jas26xinyi/2026FPGA/password_lock_system/实机验证报告.md

# FPGA 密码锁实机验证报告

## 验证环境

- 开发板：HX7A75A，器件 `xc7a75tfgg484-2`
- 工具：Vivado 2023.2
- 当前构建参数：`ENABLE_RPI_CAMERA=1`
- 输入设备：连接至 J2 的 4×4 矩阵键盘
- 下载方式：JTAG 下载 `password_lock_top.bit`

## 已通过项目

| 项目 | 实测结果 |
|---|---|
| 上电初始化 | 正常进入 `PASS` 等待状态 |
| 数码管 | 位选、段码和状态文字显示正确 |
| 矩阵键盘 | 调整 FPGA 行列管脚角色后，16 键映射正确 |
| SW1 输入启动 | 低到高拨动后进入密码输入状态 |
| 默认密码 | `1234` 可正常进入 `OPEN` |
| 输入编辑 | 数字输入、`B` 退格、`C` 取消和不足四位确认均正确 |
| 8 秒超时 | 未开锁且无操作时回到 `PASS` |
| 16 秒超时 | `OPEN` 后无操作自动上锁并回到 `PASS` |
| 错误计数 | 依次显示 `Err1`、`Err2`、`Err3`，第四次进入 `ALAr` |
| 报警解除 | 报警时矩阵键盘无权解除，仅 KEY2 有效 |
| 解除后计数 | KEY2 后重新输入，下一次错误从 `Err1` 开始 |
| 解除后输入 | KEY2 后直接恢复新一轮输入，无需重新拨动 SW1 |
| 报警显示 | LED4 按约 2 Hz 节拍闪烁 |
| 蜂鸣器 | 当前实板 P20 为高电平使能，间歇报警音正常 |
| 管理员改密 | KEY1、`SEt`、四位密码、`A`、`SAVE` 流程正常 |
| 新旧密码切换 | 新密码 `2580` 生效，旧密码 `1234` 被拒绝 |
| Flash 复位恢复 | KEY4 复位后仍可使用 `2580` |
| Flash 掉电保持 | 断电 5 秒、重新上电并下载同一程序后，`2580` 仍可开锁 |
| FPGA→Pi 报警串口 | 第四次错误后 Raspberry Pi 收到 `ALARM` 并成功回传 ACK |
| CSI 四帧抓拍 | 两轮真实报警均完成四张 `640×480` JPEG，单轮约 1.35 秒 |
| HDMI 四宫格 | 抓拍后全屏显示最新 `mosaic.jpg`，第二轮报警会替换为新画面 |
| 报警解除后图像保留 | KEY2 停止声光报警后，HDMI 四宫格持续显示，不退回色条 |

## 实测中修正的问题

- 数码管位选改为共阳低有效，并按板卡实际位序修正约束。
- 矩阵键盘接线呈转置关系，通过交换 FPGA 行/列端口角色修正，不要求重新接线。
- 管理员解除报警时清零错误次数，避免出现 `Err5` 至 `Err7`。
- KEY2 解除报警后直接进入新输入会话，同时复位键盘扫描器。
- 蜂鸣器极性以当前实板为准改为高电平使能；旧版手册的低电平说明不适用于当前板卡。
- 当前实板操作方向确认：SW1 拨上后可进入工作状态并使用 KEY1 进入 `SEt`；SW5 拨上后蜂鸣器通路接通。
- W25Q64 的连续 SPI 指令之间加入安全的片选高电平间隔；修正后写入、回读、复位恢复和掉电保持均通过。

## 尚未进行的硬件验证

新增的 KEY3 临时密码功能已完成 RTL 仿真，包括四位十进制密码生成、固定密码与临时密码并行开锁、再次生成后旧临时密码失效，以及复位后临时密码清除。该功能尚未将新版位流下载到开发板复测，因此暂不列入上方实机通过项目。

原有 FPGA 直连 OV5640、四帧 BRAM 和 HDMI 输出方案已经删除。新方案使用 FPGA UART 通知 Raspberry Pi 5，由树莓派连接 CSI 摄像头并输出 HDMI 四宫格；该新链路已完成板间接线、CSI 相机与显示器联调。

## 新方案本地验证

- FPGA UART 字节发送、接收、`ALARM` 消息、`ACK` 识别和未确认重发测试通过。
- 基础功能、临时密码与拍摄接口共 11 组 Vivado XSim 仿真全部通过；原生 WDB/VCD、PNG 和日志位于仓库根目录 `simulation_waveforms/`。
- `ENABLE_RPI_CAMERA=1` 的综合和实现均为 0 error，DRC 违规为 0；WNS `11.318 ns`、WHS `0.060 ns`，全部时序约束满足。
- `ENABLE_RPI_CAMERA=0` 的 RTL 综合检查通过，确认参数关闭路径有效。
- 树莓派协议、四宫格顺序和启动恢复共 6 项 Python 单元测试通过。
- 2026-09-08 实机联调确认 GPIOA UART、Raspberry Pi 5、CSI OV5647 相机与 HDMI 显示器完整工作；两次报警生成不同哈希的 `mosaic.jpg`，旧记录同时保留。
- 树莓派桌面登录自启动已安装；程序重启后可恢复最新四宫格并继续监听 `/dev/ttyAMA0`。

## 当前板上密码

实机验证结束时，W25Q64 中保存的管理员密码为 `2580`。如需恢复为 `1234`，按 KEY1 进入 `SEt`，输入 `1234` 后按 `A`，等待 `SAVE` 返回 `PASS`。
