jas26xinyi/2026FPGA/simulation_waveforms/12_lock_controller_fsm/notes/14_open_timeout.md

# 14_open_timeout：开锁 2000 拍自动关锁

窗口：**34470–54660 ns**，连续绝对时间；scenario=14。

## 原生 Vivado 截屏

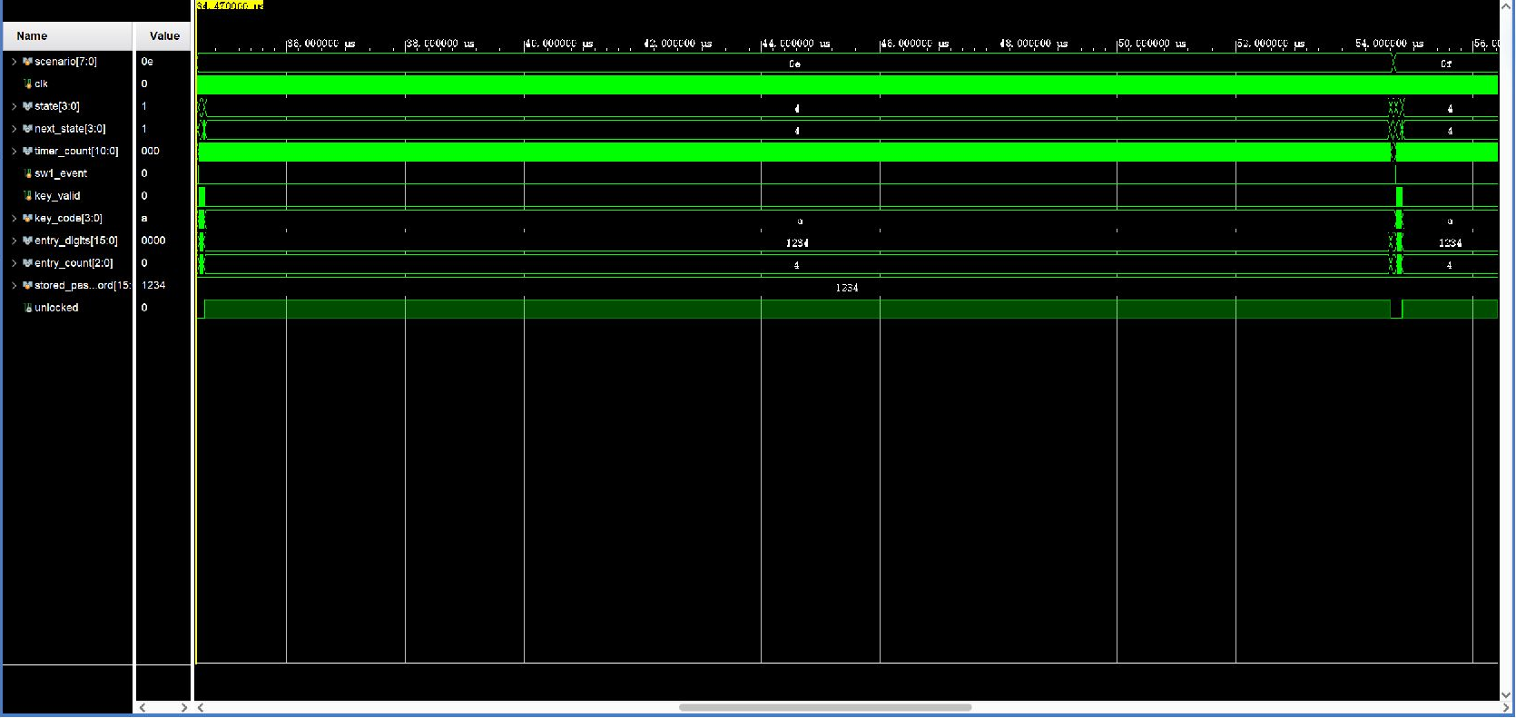
[picture p50: simulation_waveforms/12_lock_controller_fsm/images/14_open_timeout_native.png]
原生 Vivado 分段波形


这是 Vivado 2023.2 的 Wave 面板实际截图，未重绘波形。左侧 Name/Value 列的 Value 是黄色游标位置的瞬时值，不一定是事件发生时的值；请按图中横向时间轴和下表判读。state 编码：0 BOOT、1 WAIT、2 USER、3 ERROR、4 OPEN、5 ADMIN、6 SAVE、7 ALARM、8 TEMP。密码和 key_code 为十六进制 BCD。

## 前置条件

WAIT，永久密码 1234。

## 当前激励与状态变化

SW1+1234+A 先成功进入 OPEN。没有其他活动，计时至 1999 后，下一上升沿 OPEN→WAIT；unlocked=0，timer_count=0。完整图覆盖验证激励，边界图显示精确触发。

所有事件输入都由测试平台产生一个 10 ns 周期的脉冲。key_valid=1 时 key_code 才是当前新按键；key_valid=0 时保留的 key_code 不是重复激励。next_state 是组合判断，state 在下一上升沿更新；采样后 save_request/capture_start 高一个完整周期。

## 实际端口跳变、采样沿与效果

下表由这次 XSim 的 VCD 数据逐拍反查；`T` ns 的测试平台激励一般在 `clk` 下降沿改变，下一次 `clk` 上升沿在 `T+5` ns 采样。状态/输出用采样后的值，不把 `key_valid` 释放沿误认为第二次按键。表中明确用 0→1 和 1→0 表示端口边沿；若放大窗口中没有新输入边沿，则写明由前序激励或自然计时触发。

| 激励时刻/ns | 输入端口变化 | clk 上升沿/ns | 状态、输出端口实际效果 / 功能 |
| --- | --- | --- | --- |
| 34510 | `sw1_event 0→1` | 34515 | `state 1:WAIT/PASS→2:USER` |
| 34520 | `sw1_event 1→0` | 34525 | `state=2:USER` 保持 |
| 34530 | `key_valid 0→1`, `key_code A→1` | 34535 | `state=2:USER` 保持, `entry_digits 0000→0001`, `entry_count 0→1`, 有效键码 `1` |
| 34540 | `key_valid 1→0` | 34545 | `state=2:USER` 保持, 按键有效位释放，不重复提交 |
| 34550 | `key_valid 0→1`, `key_code 1→2` | 34555 | `state=2:USER` 保持, `entry_digits 0001→0012`, `entry_count 1→2`, 有效键码 `2` |
| 34560 | `key_valid 1→0` | 34565 | `state=2:USER` 保持, 按键有效位释放，不重复提交 |
| 34570 | `key_valid 0→1`, `key_code 2→3` | 34575 | `state=2:USER` 保持, `entry_digits 0012→0123`, `entry_count 2→3`, 有效键码 `3` |
| 34580 | `key_valid 1→0` | 34585 | `state=2:USER` 保持, 按键有效位释放，不重复提交 |
| 34590 | `key_valid 0→1`, `key_code 3→4` | 34595 | `state=2:USER` 保持, `entry_digits 0123→1234`, `entry_count 3→4`, 有效键码 `4` |
| 34600 | `key_valid 1→0` | 34605 | `state=2:USER` 保持, 按键有效位释放，不重复提交 |
| 34610 | `key_valid 0→1`, `key_code 4→A` | 34615 | `state 2:USER→4:OPEN`, `unlocked 0→1`, 有效键码 `A` |
| 34620 | `key_valid 1→0` | 34625 | `state=4:OPEN` 保持, 按键有效位释放，不重复提交 |
| 54615 | 无新外部脉冲；计时或状态逻辑自然转移 | 54615 | `state 4:OPEN→1:WAIT/PASS`, `entry_digits 1234→0000`, `entry_count 4→0`, `unlocked 1→0` |

窗口起点：`rst=0`, `flash_init_done=1`, `sw1_event=0`, `admin_event=0`, `alarm_clear_event=0`, `temporary_event=0`, `key_valid=0`, `key_code=A`, `save_done=0`, `save_success=0`, `stored_password=1234`, `temporary_password=0000`, `temporary_valid=0`, `flash_fault=0`。

## 对应实际功能

SW1+1234+A 先成功进入 OPEN。没有其他活动，计时至 1999 后，下一上升沿 OPEN→WAIT；unlocked=0，timer_count=0。完整图覆盖验证激励，边界图显示精确触发。

## 再次打开与分段截屏

配置：[WCFG](../configs/14_open_timeout.wcfg)，完整数据：[WDB](../tb_lock_controller_fsm.wdb)、[VCD](../tb_lock_controller_fsm.vcd)。

在 Vivado Tcl Console 执行（将路径替换为本地仓库路径）：

```tcl
open_wave_database -noautoloadwcfg E:/26FPGA/simulation_waveforms/12_lock_controller_fsm/tb_lock_controller_fsm.wdb
open_wave_config E:/26FPGA/simulation_waveforms/12_lock_controller_fsm/configs/14_open_timeout.wcfg
# 时间窗口已内嵌在 WCFG；打开配置即恢复对应分段。
```
