jas26xinyi/2026FPGA/simulation_waveforms/01_basic_entry_timeout/result.txt

PASS
testbench=tb_basic_entry_timeout
simulator=Vivado XSim 2023.2
vcd=E:/26FPGA/simulation_waveforms/01_basic_entry_timeout/tb_basic_entry_timeout.vcd
wdb=E:/26FPGA/simulation_waveforms/01_basic_entry_timeout/tb_basic_entry_timeout.wdb
