jas26xinyi/2026FPGA/simulation_waveforms/04_matrix_keypad/result.txt

PASS
testbench=tb_keypad_scanner
simulator=Vivado XSim 2023.2
vcd=E:/26FPGA/simulation_waveforms/04_matrix_keypad/tb_keypad_scanner.vcd
wdb=E:/26FPGA/simulation_waveforms/04_matrix_keypad/tb_keypad_scanner.wdb
