jas26xinyi/2026FPGA/技术文档及例程/OLED/hx75_OLED/hx75_OLED.srcs/constrs_1/new/oled.xdc

set_property PACKAGE_PIN T4 [get_ports sck]
set_property IOSTANDARD LVCMOS33 [get_ports sck]
set_property PACKAGE_PIN T5 [get_ports miso]
set_property IOSTANDARD LVCMOS33 [get_ports miso]
set_property PACKAGE_PIN U5 [get_ports reset_oled]
set_property IOSTANDARD LVCMOS33 [get_ports reset_oled]
set_property PACKAGE_PIN W6 [get_ports dc]
set_property IOSTANDARD LVCMOS33 [get_ports dc]
set_property PACKAGE_PIN Y18 [get_ports clk]
set_property IOSTANDARD LVCMOS33 [get_ports clk]

set_property PACKAGE_PIN W5 [get_ports cs]
set_property IOSTANDARD LVCMOS33 [get_ports cs]
