jas26xinyi/2026FPGA/(commit log)

2026-09-04 Replace FPGA camera path with Raspberry Pi bridge
    [app.py, camera.py, display.py, lock_controller.v, mosaic.py, password_lock_system.xdc, password_lock_top.v, protocol.py]
2026-09-17 Add native Vivado lock controller waveforms
    [segments.csv, transitions.csv]
